busyDuckman/robbie_openscad/reference_images/G1003-150P00A-PCB-Best-Mouse-Micro-Switch-1-2.png

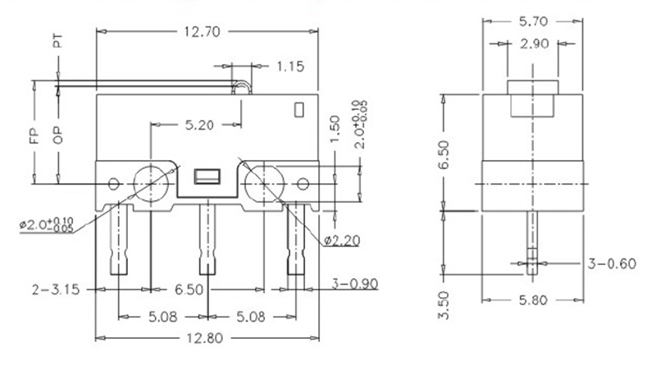
reference_images/G1003-150P00A-PCB-Best-Mouse-Micro-Switch-1-2.png
