busyDuckman/robbie_openscad/reference_images/microd.png

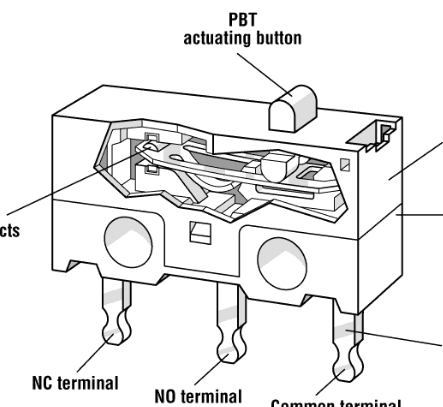
reference_images/microd.png
