busyDuckman/robbie_openscad/(list of files, cad)

Other CAD files:
blender/robbie.blend
