busyDuckman/robbie_openscad/(commit log)

2026-10-11 sensors on sleds
2026-10-11 wire routing
2026-10-12 microswitch alignment fixed after several test prints
2026-10-13 engine mounts
2026-10-13 gear offset
2026-10-13 motor mount
2026-10-13 spiffy wire passthrough
2026-10-13 bearings added
2026-10-13 screws added
2026-10-13 expandable assembly.
2026-10-13 parts system updated, 3d print orientations added
2026-10-19 drop back to 4g screw
2026-10-19 clearances now printed
